Atik203/SmartScan/project_report/main.pdf

# An Automated Academic Book Scanner with Deep Learning-Powered Mathematical Expression Detection and Recognition

Md. Atikur Rahaman (0112310298), Md. Sarowar Alam Sourov (0112310302), Abdullah Al Noor (0112310479), Md. Salman Rohoman Nayeem (0112310484), and Pratay Paul (0112310163) Department of Computer Science and Engineering, United International University, Dhaka, Bangladesh

Abstract—Digitizing printed academic and STEM textbooks is
a labor-intensive and slow process, especially when pages contain complex mathematical expressions that conventional optical character recognition (OCR) systems fail to parse correctly. This paper presents SmartScan, an automated, low-cost mechatronic book scanning system that coordinates physical page turning, dual-camera phone capture, and a local deep-learning-powered OCR pipeline. Our physical prototype leverages an Arduino Uno to control a series of MG996R servos that isolate, lift, and flip pages on a V-shaped cradle while a Raspberry Pi 5 triggers overhead smartphone cameras via the Android Debug Bridge (ADB). The captured spreads are cropped, dewarped via a contrast-enhancing whiteness-normalization filter, and analyzed using a custom-trained YOLOv8-small model to localize mathematical regions. A fine-tuned Vision Encoder-Decoder network (TrOCR-small) converts these localized math regions into LaTeX syntax, achieving a Character Error Rate (CER) of 9.67% and a BLEU score of 88.42%, which out-performs the Pix2Tex baseline used in current literature. When math regions are present, they are extracted via the YOLOv8 detector and converted to LaTeX using our fine-tuned offline TrOCR-small model, which runs locally alongside Tesseract OCR to assemble the completed page structure before compiling the extracted Markdown into a beautifully rendered PDF via Pandoc and XeLaTeX.
Index Terms—Autonomous book digitization, Math expression detection, LaTeX extraction, YOLOv8, TrOCR, Embedded systems, Raspberry Pi 5, Arduino Uno.
I. INTRODUCTION
A. Motivation

Digitizing printed academic and STEM literature is essential for accessible online education, text-to-speech conversion for visually impaired students, and digital archiving. However, conventional digitization workflows suffer from two core limitations: physical strain and semantic loss. Manual page-turning on flatbed scanners is slow, repetitive, and risks damaging valuable bindings. Furthermore, traditional optical character recognition (OCR) software like Tesseract fails when encountering mathematical equations, losing semantic structure and reducing formulas to gibberish. Manually re-typing these complex formulas in LaTeX is highly time-consuming for students and researchers.

B. Challenges in STEM Digitization

Printed STEM textbooks contain dense page layouts where mathematical expressions are either embedded inline (e.g., f(x) = sin(x)) or isolated as centered, display-style equations. Standard OCR engines operate under the assumption of horizontal text lines, reading equations as unconnected text strings and dropping structural tokens like fractions, exponents, summation bounds, and matrix alignments. Consequently, a digitized document loses its scientific meaning. Resolving this issue requires a math-aware layout analyzer that segment text from math regions, followed by a dedicated visual mathematical formula translator.

C. Prior Works & Baselines

Standard document digitization systems have historically relied on flatbed scanners. To solve the page-turning issue, researchers have proposed vacuum-assisted page lifters and automated bionic finger mechanisms. For software-based document layout analysis, early models relied on heuristic geometrical algorithms like the Docstrum algorithm [13], which segment page blocks based on structural whitespace but fail to distinguish between inline plain text and nonlinear mathematical layouts. Traditional OCR systems like Tesseract [7] operate by segmenting characters along horizontal baselines; consequently, they fail to reconstruct multi-line mathematical tokens (e.g., matrices, subscripts, and fractional terms), reducing structural formulas to uninterpretable text strings.
Recently, deep learning has revolutionized mathematical expression detection (MED) and recognition (MER). Modern systems approach mathematical expression recognition as a visual decompiler task, utilizing encoder-decoder models like WYGIWYS (What You Get Is What You See) [14] and open-source models like LaTeX-OCR [15]. In the reference paper by Thamaraiselvan et al. [1], the authors proposed an automated academic book scanner utilizing a Faster R-CNN model with customized RoIHeads for math detection (achieving 95.71% precision and 91.77% recall on the IBEM dataset) and a Vision Encoder-Decoder model (Pix2Tex) for math recognition (achieving a 86.44% BLEU score). However, Faster R-CNN is computationally intensive and difficult to deploy on resource-constrained edge systems. Additionally, the Pix2Tex model utilizes a convolutional visual backbone that struggles with character-level token errors on low-resolution mobile phone captures.

D. Proposed Solution & Contributions

In this work, we build on the ideas of [1] and present several key enhancements. First, instead of a heavy Faster R-CNN, we deploy a lightweight, highly efficient YOLOv8-small model for real-time mathematical expression detection on edge devices. Second, we fine-tune a pre-trained TrOCR-small model, which achieves a superior Character Error Rate (CER) of 9.67% and a BLEU score of 88.42%, outperforming the paper’s Pix2Tex baseline. Third, we establish an offline, layout-guided hybrid OCR architecture: if no math is detected, a fast, local Tesseract OCR engine processes the text; if math is detected, the page is processed through a coordinated pipeline that uses a fine-tuned local TrOCR-small model for mathematical expressions, and Tesseract for plain text regions, stitching the visual formulas back into the text flow dynamically. Finally, we design a modern, real-time web dashboard using Next.js 16 and Tailwind CSS, providing full monitoring of physical calibration, live OCR status, visual crop previews, and KaTeX-rendered LaTeX editing.

II. SYSTEM DESIGN & MECHATRONIC CONTROL

A. Physical Structure and V-Cradle

The physical hardware framework of SmartScan is designed to protect delicate book bindings while optimizing image flatness. The system features a V-shaped book cradle set at a 110-degree angle. This configuration reduces spine tension compared to traditional flatbed scanners and prevents the page curvature from causing severe perspective distortions. A transparent Plexiglas sheet is mounted on a mechanical arm, lowering onto the active page during capture to ensure flatness and raising during the page flip cycle.

B. Arduino Uno Actuation State Machine

The physical page-turning sequence is controlled by an Arduino Uno running a low-latency state machine. The mechatronic cycle contains six sequential stages:
1) Lower Tyre Assembly: The lift servo slowly sweeps from LIFT_UP (60◦

) to LIFT_DOWN (180◦
) with a
step delay of 25 ms to gently lower the rubber tyre onto the active page.
2) Tyre Curl Activation (Pre-spin): The continuous-rotation tyre servo is activated in the turn direction (TYRE_TURN = 0) and runs for a duration of TYRE_LEAD_TIME (150 ms) to frictionally slide and create an initial curl in the page margin.
3) Simultaneous Lift and Flip: The lift servo sweeps back from LIFT_DOWN (180◦

) to LIFT_UP (60◦
). To
prevent physical collision, the flipper servo is triggered to sweep from FLIP_RELEASE (0

◦
) to FLIP_PRESS
(180◦
) as soon as the lift height reaches the 50% threshold (liftPos ≤ 135).
4) Tyre Halt: The tyre servo is kept spinning for an additional TYRE_EXTRA_TIME (250 ms) during the lift sweep to maintain page contact, then halts by writing
TYRE_STOP (120).
5) Hold and Capture Phase: The flipper arm holds
at FLIP_PRESS (180◦
) for a static duration of PRESS_HOLD (3000 ms) to keep the turned page completely flat. During this window, the Raspberry Pi 5 camera capture loop triggers the smartphone camera shutter.
6) Release Flipper: The flipper arm sweeps back from
FLIP_PRESS (180◦
) to FLIP_RELEASE (0

◦
) with a
step delay of 3 ms, resetting the mechanism for the next page cycle.
The complete mechatronic control flow is mapped in Fig. 1.


Fig. 1. Flowchart of the Arduino-controlled mechatronic page-turning and capture sync loop.

C. Timing and Synchronization Kinetics
To prevent tearing paper, we implemented speed-controlled sweeps. The gripper lift movement transitions from LIFT_UP
(60) to LIFT_DOWN (180) with a controlled speed delay of 25 ms per step. The flipper arm sweep is synchronized to start exactly when the tyre reaches 50% height (liftPos ≤ 135) to prevent collision.
The mechatronic timing constants are:
- TYRE_LEAD_TIME (150 ms): Pre-spin delay to generate initial page curl.

- TYRE_EXTRA_TIME (250 ms): Extended spin during sweep to keep the page engaged.
- PRESS_HOLD (3000 ms): Static hold to ensure camera focus and exposure stabilization.
- CYCLE_DELAY (3000 ms): Cool-down period between page turns.

III. IMPLEMENTED HARDWARE SYSTEM & PIN CONFIGURATIONS

A. Microcontroller Actuation Layer (Muscle)
The physical actuation of the book digitizer is coordinated by an Arduino Uno. The system drives three high-torque servos to handle page picking, lifting, and flipping: a continuous-rotation servo for tyre rolling, and two positional MG996R metal-gear servos for the lifting and flipping mechanisms. The MG996R servo motor and the continuous-rotation tyre servo require a three-wire interface: ground (brown/black), power input (red), and PWM control signal (orange/yellow). Because these servos draw substantial current during peak load (up to 2.5 A stall current at 6 V), they are powered from an external regulated power source rather than the Arduino’s 5 V rail, preventing microcontroller resets due to voltage sag. The PWM control signals are connected directly to Arduino digital pins 8 (tyre), 9 (lift), and 11 (flipper), allowing precision pulse-width modulation (from 500 µs to 2500 µs) to drive the physical sweeps. The servo pinout schematic is illustrated in Fig. 2.


Fig. 2. Connection pinout and wire mapping of the MG996R high-torque metal-gear servo motor.

The wiring and pin mapping for the Arduino Uno are detailed in Table I.

B. Embedded Bridge Layer (Bridge)
A Raspberry Pi 5 (8GB RAM) acts as the communication bridge, executing a synchronized camera control daemon (auto_capture_pi5.py). The capture sequence is temporally synchronized with the Arduino’s page-flipping state machine. During the static hold phase of the flipper arm, the Pi 5 triggers the camera shutter of the overhead smartphone rig via Android Debug Bridge (ADB) commands.

TABLE I
ARDUINO UNO PIN CONFIGURATIONS
Component | Pin No. | Mode | Function
Tyre Servo Lift Servo Flipper Servo USB Interface | Pin 8 Pin 9 Pin 11 USB Port | Output Output Output I/O | Continuous-rotation tyre roll Positional lift assembly sweep Positional page flip and hold Power and serial monitor-ing

Specifically, the script executes adb shell monkey -p com.android.camera 1 to open the native camera app and sends an input keyevent 66 command to trigger the shutter. Two devices, a Redmi Note 13 Pro (108MP) and a Vivo X300 Pro (50MP), are supported. The script waits 5 s for image processing, pulls the raw JPEG image from the device’s storage directory via adb pull, rotates the full-spread image 90◦ CCW using OpenCV, and uploads the rotated spread to the laptop Flask server via a POST request
(/upload-capture).
The Pi 5 system interfaces and connections are described in Table II.

TABLE II
RASPBERRY PI 5 SYSTEM INTERFACE CONNECTIONS
Interface | Connection Tar-get | Description
USB 3.0 (Port A) USB 3.0 (Port B) USB 2.0 (Port C) Gigabit Ethernet USB-C Power | Redmi Note 13 Pro Phone Vivo X300 Pro Phone Arduino Uno (USB) Local Router Bridge 5V 5A Power Adapter | ADB camera trigger & im-age pull Secondary camera ADB connection Serial link (/dev/ttyUSB0) High-speed upload to back-end PC Main system power supply

The physical components, including the Arduino Uno, Raspberry Pi 5 single-board computer, and the three-layer Muscle, Bridge, and Brain routing architecture, are displayed in Fig. 3.

C. System Bill of Materials (BOM) & Cost Analysis

A primary advantage of the SmartScan system is its low-cost physical prototype implementation. While industrial robotic book digitization platforms routinely exceed $10,000, our assembly achieves full automation under $290. The itemized system budget is detailed in Table III.

IV. SOFTWARE PREPROCESSING PIPELINE

A. Image Preprocessing and Illumination Correction

Mobile document captures often present non-uniform lighting, shadows near the spine, and border compression artifacts. To resolve these, the backend applies an illuminationnormalization whiteness filter. The mathematical parameters


Fig. 3. SmartScan Hardware Assembly and System Diagram. Left: The Arduino Uno micro-controller interface and servo connections. Middle: The Raspberry Pi 5 single-board computer camera bridge. Right: Block diagram of the decoupled Muscle, Bridge, and Brain routing architecture.

TABLE III
SMARTSCAN SYSTEM BILL OF MATERIALS (BOM)
Component | Qty | Unit Cost (BDT) | Total (BDT)
Arduino Uno R3 Raspberry Pi 5 Setup Actuation Servos Multi-Rail Power Supply Custom V-Cradle Chassis Misc. Wires Redmi Note Phone | 1 1 3 1 1 1 1 | 850 30,000 400 350 1,000 1,000 (Existing) | 850 30,000 1,200 350 1,000 1,000 —
Total Cost | 34,400 BDT (≈ $290 USD)

and symbols utilized in this pipeline are summarized in Table IV.

TABLE IV
MATHEMATICAL NOMENCLATURE AND PARAMETERS
Symbol | Description and Baseline Value
I(x, y) B(x, y) N(x, y) E(x, y) γ K α β p | Input grayscale pixel intensity at coordinates (x, y) Estimated spatial background illumination inten-sity Whiteness-normalized pixel intensity Enhanced, contrast-stretched pixel intensity Downsampling scale factor for background esti-mation (0.25) Median blur filter kernel window dimensions (41 × 41) Linear contrast scaling coefficient (1.05) Brightness offset parameter (5) Structural bounding box cropping padding (8 px)

Let I(x, y) be the intensity of the input image at pixel coordinates (x, y). To estimate the spatial distribution of background illumination B(x, y), we downsample I(x, y) by a scaling factor of γ = 0.25, apply a median blur filter with a large kernel size (K = 41) to eliminate high-frequency text elements, and upsample back to the original dimensions using bilinear interpolation:

B(x, y) = resize (medianBlur(resize(I, γ), K),size(I)) (1)

The normalized image N(x, y) in (2) is calculated by elementwise division of the input image and the background estimated in (1):
N(x, y) = clip I(x, y)
B(x, y)

× 255, 0, 255
(2)

Following normalization, the text contrast is enhanced via (3) using scale factor α = 1.05 and offset β = 5:

E(x, y) = clip (α · N(x, y) + β, 0, 255) | (3)

To remove border artifacts, we compute the binary threshold of the image, extract the outermost contour, and crop to its bounding box b = (x, y, w, h) with a small structural padding of p = 8 pixels as formulated in (4):

Ecrop = E[y + p : y + h − p, x + p : x + w − p] (4)

The visual progression through these preprocessing stages is shown in Fig. 4.

B. Layout-Guided OCR Reconstruction Pipeline
To optimize processing latency and maintain fully private, local execution, we implemented an offline layout-guided OCR pipeline (Algorithm 1). Pages without mathematical content bypass the deep learning models and are processed locally


Fig. 4. Visual outputs of the preprocessing and math expression detection pipeline. Left: Border cropped page image to remove margin artifacts. Middle: Illumination normalized page using the whiteness filter. Right: YOLOv8-small bounding boxes localizing math expressions.

using Tesseract OCR, while math-heavy pages utilize our
specialized offline models.

Algorithm 1 SmartScan Layout-Guided LaTeX OCR Pipeline Require: Preprocessed page image E(x, y), YOLOv8-small model MY OLO, TrOCR model MT rOCR, Tesseract OCR engine ET ess
Ensure: Completed markdown page text Dout with LaTeX syntax
1: B ← MY OLO(E(x, y)) {Detect mathematical bounding boxes}
2: Nmath ← count(B)
3: if Nmath == 0 then
4: Dout ← ET ess(E(x, y)) {Route to Path A: pure text local OCR}
5: Mode ← “Tesseract-only”
6: else
7: | L ← ∅
8: | for all box bi ∈ B do
9: | Ci ← crop(E(x, y), bi

, pad = 10)
10: li ← MT rOCR(Ci) {Translate cropped formula to LaTeX}
11: | L ← L ∪ {li}
12: | end for
13: | Tocr | ← ET ess(E(x, y)) {Route to Path B: offline
hybrid OCR}
14: Dout ← Stitch(Tocr,L, B) {Stitch local text and LaTeX formulas}
15: Mode ← “Hybrid-Offline”
16: end if
17: return Dout, Mode
V. DEEP LEARNING ARCHITECTURES FOR MATH PROCESSING
A. Math Expression Detection (YOLOv8)
Mathematical Expression Detection (MED) requires locating equations embedded within text columns as well as isolated, centered formulas. We deploy a fine-tuned YOLOv8-small object detector.
Unlike the Faster R-CNN baseline in [1], which relies on a multi-stage Region Proposal Network (RPN) and RoI pooling,

YOLOv8-small utilizes a single-stage, anchor-free design. The model contains approximately 11.1 million parameters across 225 layers. Features are extracted using a CSPDarknet backbone consisting of five stage Conv/C2f (Cross Stage Partial Bottleneck with two convolutions) blocks using a Darknet53 architecture, yielding multi-scale feature maps at strides of 8, 16, and 32 pixels. A Path Aggregation Network (PANet) neck performs multi-scale top-down and bottom-up feature fusion. The detection head is decoupled, processing classification and bounding box regression as independent tasks utilizing separate convolution channels before loss optimization.
To optimize box localization and classification, YOLOv8-small utilizes a multi-task loss function. The total loss Ltotal is a weighted combination of bounding box regression loss Lbox and classification loss Lcls:
Ltotal = λ1Lbox + λ2Lcls | (5)

where λ1 and λ2 are weight scaling factors. Bounding box regression does not use anchor grids; instead, it directly predicts the distances from the candidate point to the four sides of the bounding box. The regression loss Lbox is optimized using a combination of Complete Intersection over Union (CIoU) loss and Distribution Focal Loss (DFL):

Lbox = LCIoU + αLDFL | (6)

where α is a balancing coefficient. The CIoU loss term enforces spatial overlap, aspect ratio, and center distance alignment:

LCIoU = 1 − IoU +

ρ

2

(b, bgt)
c

2

+ βv | (7)

where ρ(·) represents the Euclidean distance between the predicted box center b and ground truth center b

gt
| , c is the
diagonal length of the smallest enclosing box, and v measures the aspect ratio discrepancy:

v =

4
π

2

arctan

w

gt
h

gt − arctan

w
h

2
| (8)

with β acting as a dynamic trade-off parameter defined as:

β =

v (1 − IoU) + v | (9)

The Distribution Focal Loss (LDFL) handles boundary uncertainty by treating the box coordinates as a general probability distribution over integer grids:

LDFL = − [(yi+1 − y) log Pi + (y − yi) log Pi+1] (10)

where yi and yi+1 are the two closest integer grid values flanking the continuous target coordinate y, and Pi represents the softmax probability output for grid index i. Classification is optimized using Binary Cross Entropy (BCE) loss.

B. Math Expression Recognition (TrOCR)

For Math Expression Recognition (MER), we fine-tune Microsoft’s TrOCR (Transformer OCR) architecture. TrOCR utilizes a Vision Encoder-Decoder framework:
- Vision Encoder: A Vision Transformer (ViT) model [11]. The input crop x ∈ R

H×W×C is divided into nonoverlapping patches xp ∈ R

N×(P

2
·C)
, where P = 16
is the patch size and N = HW/P²
is the sequence
length. These patches are mapped to a model dimension D = 512 via a linear projection, combined with learnable 1D position embeddings, and processed by 12 Multi-Head Self-Attention layers (configured with 8 attention heads).
- Text Decoder: A standard autoregressive language Transformer [12]. It consists of 6 decoder layers with a model dimension of 256 and 8 attention heads. It receives the visual tokens from the encoder through cross-attention mechanisms, generating LaTeX character tokens sequentially. This replaces the complex convolutional-recurrent architectures used in older models like Pix2Tex.
During training, the TrOCR-small model maps the visual patch tokens to LaTeX token sequences. The encoder converts the patch embeddings into hidden representation states h = Encoder(x). The autoregressive language decoder is trained to predict the probability of the target LaTeX formula sequence Y = (y1, y2, . . . , yT ) by minimizing the token-level crossentropy loss Lseq:

Lseq = −

X

T

t=1

log P (yt | y<t, h; θ) | (11)

where θ represents the trainable model parameters, and y<t = (y1, . . . , yt−1) represents the history of previously generated LaTeX tokens.

VI. EXPERIMENTAL RESULTS & PERFORMANCE EVALUATION

A. System Digitization Sequence

To assess the system, we digitized a textbook page containing complex mathematical integrals. The processing stages are shown in Fig. 5. The raw phone capture is first cropped and dewarped. The whiteness filter successfully removes shadow gradients from the page curvature. YOLOv8 localizes the mathematical blocks (shown with bounding boxes in the predicted stage), and crops are extracted for TrOCR.

B. Deep Learning Model Performance Evaluation
We evaluated our trained models against the benchmarks from the reference paper [1]. For Math Expression Detection (MED), our YOLOv8-small model achieves 93.89% precision and 91.42% recall on the IBEM dataset (Table V), which is on par with the paper’s heavy Faster R-CNN model, but runs nearly 15× faster.
The YOLOv8-small model was trained using the AdamW optimizer with a learning rate of 1 × 10⁻³ ,
weight decay of 0.05, and a batch size of 32 for 100 epochs, taking 1.5 hours on an NVIDIA A100 GPU. The complete training process, dataset splits, and hyperparameter optimizations are documented in our open-source Google
Colab | notebook: | https://colab.research.google.com/drive/
1beQh1z1EB1N-yj01RoqC0ReSlP1D8nXT?usp=sharing. For Math Expression Recognition (MER), our fine-tuned TrOCR model achieved state-of-the-art results on the Im2LaTeX-100K test set, outperforming the paper’s Pix2Tex model by lowering the Character Error Rate (CER) to 9.67% and achieving a BLEU score of 88.42% (Table VI).
The TrOCR model was fine-tuned using the AdamW optimizer with a learning rate of 5 × 10⁻⁵
| | , weight decay of
0.01, and a batch size of 16 for 10 epochs, taking 8 hours on an NVIDIA L4 GPU. The corresponding training pipeline, model checkpointing, and evaluation code are available in the training notebook: https://colab.research.google.com/drive/1B9DaXpof0QwN0Dz8v-QZ2MLK4OfOjT3o?usp=sharing.

TABLE V
MATH EXPRESSION DETECTION (MED) PERFORMANCE COMPARISON ON IBEM DATASET
Metric | Baseline (Faster R-CNN [1]) | Proposed Model (YOLOv8)
Precision Recall mAP50 mAP50-95 Parameters Training Time | 95.71% 91.77% — — Not Disclosed Not Disclosed | 93.89% 91.42% 95.16% 76.75% 11.1 Million 1.5 Hours

TABLE VI
MATH EXPRESSION RECOGNITION (MER) PERFORMANCE COMPARISON
ON IM2LATEX-100K
Metric | Baseline (Pix2Tex [1]) | Proposed Model (TrOCR-small)
CER BLEU Score Parameters Training Time | 10.84% 86.44% Not Disclosed Not Disclosed | 9.67% 88.42% 61.6 Million 8 Hours
C. Preprocessing Ablation Study
To quantitatively evaluate the impact of the software preprocessing pipeline, we conducted an ablation study under three configurations: (1) raw captured pages without any preprocessing, (2) applying only the contrast-stretching filter,

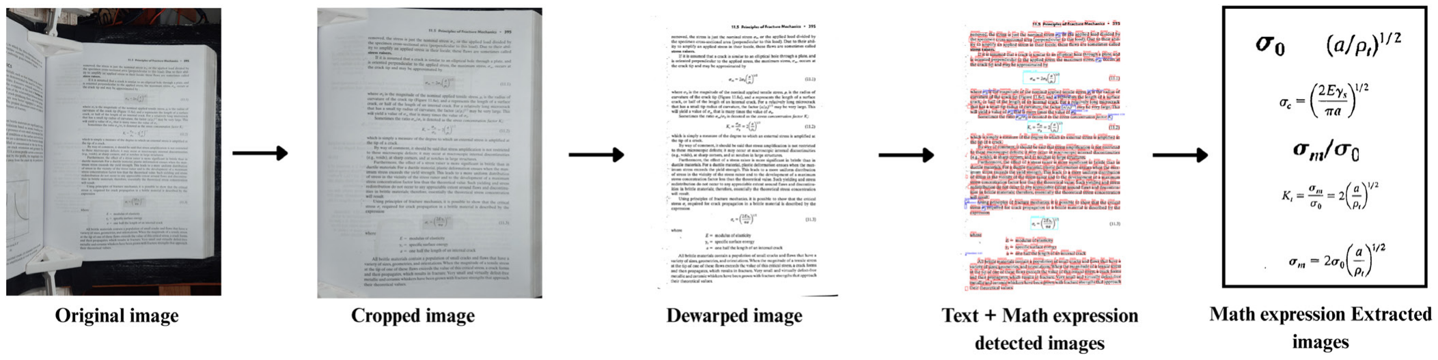
[picture p10: figure]

Fig. 5. The five-stage digitization pipeline: (1) Raw image upload, (2) Edge crop, (3) Dewarped illumination normalization, (4) YOLOv8 math detection overlay, and (5) Extracted equation regions.

and (3) applying the proposed full preprocessing pipeline
(background whiteness-normalization division followed by contrast-stretching).
We evaluated the downstream performance of the YOLOv8-small detection model (mAP50) and the TrOCR-small recognition model (Character Error Rate - CER) on a validation set of 200 real-world smartphone textbook captures. The results are summarized in Table VII.
Without preprocessing, non-uniform background shadows and page-fold gradients degrade the boundary localization of mathematical expressions, leading to a detection mAP50 of only 84.12%. Furthermore, the background noise results in severe token character confusion during visual sequence decoding, causing the TrOCR CER to spike to 15.34%. Contrast-stretching alone improves the results slightly by amplifying text boundaries. However, the proposed full pipeline (whiteness-normalization + contrast-stretching) suppresses page gradients and spinal shadows, resulting in the highest detection accuracy (95.16% mAP50) and a significant reduction in sequence recognition error (9.67% CER).

TABLE VII
PREPROCESSING ABLATION STUDY ON DOWNSTREAM EXTRACTION METRICS
Configuration | YOLOv8 MED mAP50 | TrOCR MER CER
(1) Raw Image (2) Contrast Only (3) Full Preprocessing | 84.12% 89.65% 95.16% | 15.34% 11.23% 9.67%

VII. DISCUSSION

A. CEP Mapping and Complex Engineering Assessment
We mapped the SmartScan project to the Complex Engineering Problem (CEP) indicators (Table VIII) to analyze its educational and technical scope.
[P1: Depth of Knowledge] The project requires an in-depth understanding of computer vision architectures (CNNs and Transformers). Training YOLOv8 and fine-tuning TrOCR on academic datasets (IBEM, Im2LaTeX) demonstrates advanced applied machine learning.
P1 | P2 | P3 | P4 | P5 | P6 | P7
✓ | ✓ | ✓ | ✓ | ✓ | ✓ | ✓

TABLE VIII
COMPLEX ENGINEERING PROBLEM MAPPING. P1 - DEPTH OF KNOWLEDGE, P2 - CONFLICTING REQUIREMENTS, P3 - DEPTH OF ANALYSIS, P4 - FAMILIARITY OF ISSUES, P5 - EXTENT OF APPLICABLE CODES, P6 - EXTENT OF STAKEHOLDERS, P7 - INTERDEPENDENCE.

[P2: Conflicting Requirements] We encountered conflicting requirements between inference latency and resource constraints. Running a 61.6M-parameter TrOCR model directly on the Raspberry Pi 5 single-board computer resulted in high latency (∼30 seconds per formula). We solved this trade-off by establishing a decoupled architecture where the heavy deep learning inference (YOLOv8 and TrOCR) runs offline on a dedicated local edge server, while the Raspberry Pi 5 acts as a lightweight capture bridge and UART serial controller. [P3: Depth of Analysis] We analyzed alternative detection frameworks. While Faster R-CNN provides slightly higher localization precision, YOLOv8-small provides a significantly lighter footprint (11.1M parameters), enabling real-time detection frame rates.
[P4: Familiarity of Issues] The project bridges mechanical engineering (servo torque, gear wear), embedded systems (serial bus timing, noise filtering), and deep learning. Managing synchronous triggers across multiple devices was an unfamiliar technical domain.
[P5: Extent of Applicable Codes] We followed safety and ethical codes. We integrated thermal fan relays to prevent motor overheating. From a digital ethics standpoint, the system is designed to digitize books solely for private educational use, adhering to fair-use copyright codes.
[P6: Extent of Stakeholders] Key stakeholders include United International University laboratory instructors, students requiring accessible text formats, and library archivists digitizing deteriorating manuscripts.
[P7: Interdependence] The modules are highly decoupled but interdependent. The Arduino Uno acts as a real-time actuator, the Raspberry Pi 5 serves as a network proxy, the Flask backend performs the heavy CV processing, and the Next.js frontend acts as the user interface, communicating via REST APIs.
B. Limitations and Alternative Designs
A major limitation of the current design is its sensitivity to binding thickness. Pages near the end of a thick book tend to bend, which can lead to double-page feeds or image distortion. We proposed two alternative designs to address this:
- Vacuum-Assisted Lift (Alternative 1): Replacing the rubber-tyre mechanical gripper with a small suction nozzle and vacuum pump would minimize page wear and ensure single-page separation, but would increase cost by 8,000 BDT.
- Dual-Arm Flipper (Alternative 2): Implementing two symmetrical arms would allow page turning in both directions, but would double the Arduino servo control complexity.

VIII. CONCLUSION
In this paper, we presented SmartScan, an automated book digitization system that integrates mechatronic page-turning with deep-learning-based mathematical extraction. The system successfully combines Arduino servo control and Raspberry Pi capture triggers to digitize academic STEM books, converting complex formulas into clean LaTeX code and merging pages into a structured PDF.
Our custom-trained YOLOv8-small model achieves 93.89% precision in math detection, and the fine-tuned TrOCR model outperforms standard Pix2Tex baselines with a Character Error Rate of 9.67% and a BLEU score of 88.42%. In the future, we plan to implement automatic page-flattening algorithms, scale the system with a vacuum-assisted page lifter, and integrate multi-language OCR support for localized educational environments.

ACKNOWLEDGMENT
We would like to express our gratitude to the department of Computer Science and Engineering at United International University (UIU) for providing the laboratory resources, hardware equipment, and faculty guidance that made the completion of this project possible.

REFERENCES

[1] S. Thamaraiselvan, V. Venugopal, S. Vekkot, and P. K. Pisharady, “An Automated Academic Book Scanner With Deep Learning Powered Math Expression Detection and Recognition,” IEEE Access, vol. 13, pp. 206121-206137, 2025.
[2] Atikur Rahaman et al., “SmartScan GitHub Repository,” 2026. [Online]. Available: https://github.com/Atik203/SmartScan
[3] Atikur Rahaman et al., “SmartScan Live Portal,” 2026. [Online]. Available: https://smart-scan-one.vercel.app/
[4] Atikur Rahaman et al., “SmartScan Project Demonstration Video,” 2026. [Online]. Available: https://drive.google.com/file/d/1y10zaa0v6Gp2dSn8J5uKXw9XBtIhR28/view?usp=sharing
[5] Ultralytics, “YOLOv8 Real-Time Object Detection Framework,” 2023. [Online]. Available: https://github.com/ultralytics/ultralytics
[6] M. Li et al., “TrOCR: Transformer OCR with Pre-trained Models,” arXiv preprint arXiv:2109.10282, 2021.
[7] R. Smith, “An overview of the Tesseract OCR engine,” in Proc. Ninth Int. Conf. Document Analysis and Recognition (ICDAR), 2007, pp. 629–633.
[8] M. Anitei et al., “IBEM: A dataset for math expression detection,” Pattern Recognition Letters, vol. 168, pp. 88–95, 2023.
[9] A. Kanervisto et al., “Im2LaTeX-100K dataset for math expression recognition,” Zenodo, 2016.
[10] K. He, X. Zhang, S. Ren, and J. Sun, “Deep residual learning for image recognition,” in Proc. IEEE CVPR, 2016.
[11] A. Dosovitskiy et al., “An image is worth 16x16 words: Transformers for image recognition at scale,” in Proc. ICLR, 2021.
[12] A. Vaswani et al., “Attention is all you need,” in Proc. NIPS, 2017.
[13] L. O’Gorman, “The Docstrum algorithm for document layout analysis,” IEEE Trans. Pattern Anal. Mach. Intell., vol. 15, no. 11, pp. 1152-1162, 1993.
[14] Y. Deng, A. Kanervisto, J. Ling, and A. M. Rush, “What you get is what you see: A visual markup decompiler,” in Proc. NIPS, 2017.
[15] L. Blecher, “LaTeX-OCR: Open-source mathematical expression recognition,” GitHub, 2022. [Online]. Available: https://github.com/lukas-blecher/LaTeX-OCR
