Atik203/SmartScan/(commit log)

2026-04-09 feat: implement Raspberry Pi bridge for ADB capture and Flask-based YOLO processing engine
2026-05-10 feat: remove Raspberry Pi bridge scripts for auto capture functionality
2026-05-10 feat: add setup guides for Raspberry Pi and laptop environment and include Arduino controller sketch
2026-05-19 feat: add Arduino automation script for controlling fan and flipper servo mechanisms
    [Complete_automation_code_arduino.ino]
2026-05-20 feat: Enhance environment variable loading and add capture processing
    - Implemented a function to load environment variables from a local .env file with a fallback parser.
    - Updated model path resolution for YOLO and TROCR models.
    - Added a new directory for SmartScan captures.
    - Modified the GEMINI_MODEL default value for better clarity.
    - Enhanced the page assembler to extract source file information from markdown content.
    - Updated the traffic controller to handle source file metadata during markdown saving.
    - Introduced a new API endpoint for processing captures in the Flask API.
    - Enhanced the batch processing page to include capture processing functionality and display summary results.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
2026-05-20 feat: Add Arduino connectivity checks and configuration options, update health response structure, and implement PDF engine selection
2026-05-20 fix: Update Arduino model name to Uno in multiple components
2026-05-22 feat: implement backend processing pipeline and frontend API integration for document scanning and assembly
2026-05-22 feat: implement page assembly and PDF compilation logic using Pandoc and add utility module
2026-06-02 added arduino code
2026-06-06 feat: add Arduino script for automated page turner sequence control
2026-06-06 feat: add automated ADB-based image capture and processing script for dual-device setups
2026-06-06 feat: implement automated camera capture and image processing script using ADB
2026-06-06 feat: implement backend API and Raspberry Pi automation scripts for image capture and processing pipeline
2026-06-06 feat: add automatic page turner control logic for tyre, lift, and flipper servos
    [Complete_automation_code_arduino.ino]
2026-06-06 refactor: replace documentation with dedicated Raspberry Pi auto-capture scripts
    [auto_capture.py, auto_capture_pi5.py]
2026-06-06 feat: implement backend API for document processing and Raspberry Pi image capture utilities
2026-06-06 feat: add automated ADB-based image capture and post-processing scripts for Raspberry Pi 5 and Windows
2026-06-07 feat: add Arduino automation code for synchronous lift and flipper page turning mechanism
    [Complete_automation_code_arduino.ino]
2026-06-07 feat: implement page turner automation logic with sensor-based safety monitoring and jam detection
2026-06-07 feat: add arduino sensor testing and automation scripts
2026-06-10 feat: add Arduino automation code for simultaneous page turner lift and flipper operations
    [Complete_automation_code_arduino.ino]
2026-06-11 docs: remove reference to 4-stage page-flipping mechanism in presentation script
2026-06-11 docs: update presentation script to reflect friction wheel mechanism and automated capture process
2026-06-14 feat: initialize Flask backend API and Raspberry Pi automated capture script
2026-06-15 feat: implement automated camera capture and remote upload scripts for Raspberry Pi 5
