Atik203/SmartScan/(notices)

Notices in the files:
README.md:
License: MIT
